phillipdavidstearns/7s7z1s2z/images/MountPi.jpg

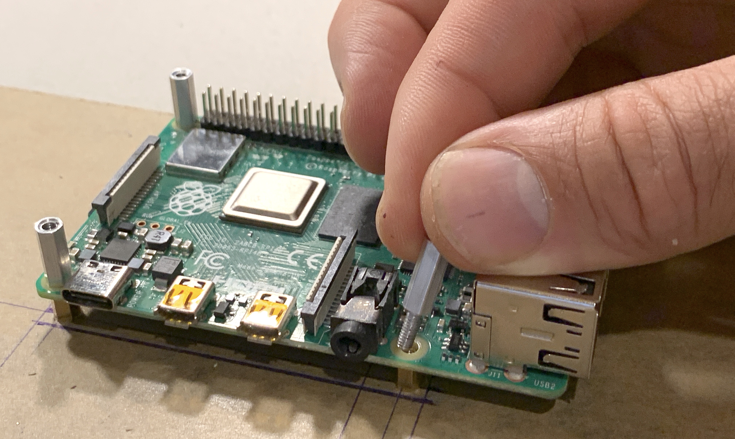
images/MountPi.jpg
