phillipdavidstearns/7s7z1s2z/PCB_rev_2/ferrite_encoder.jpg

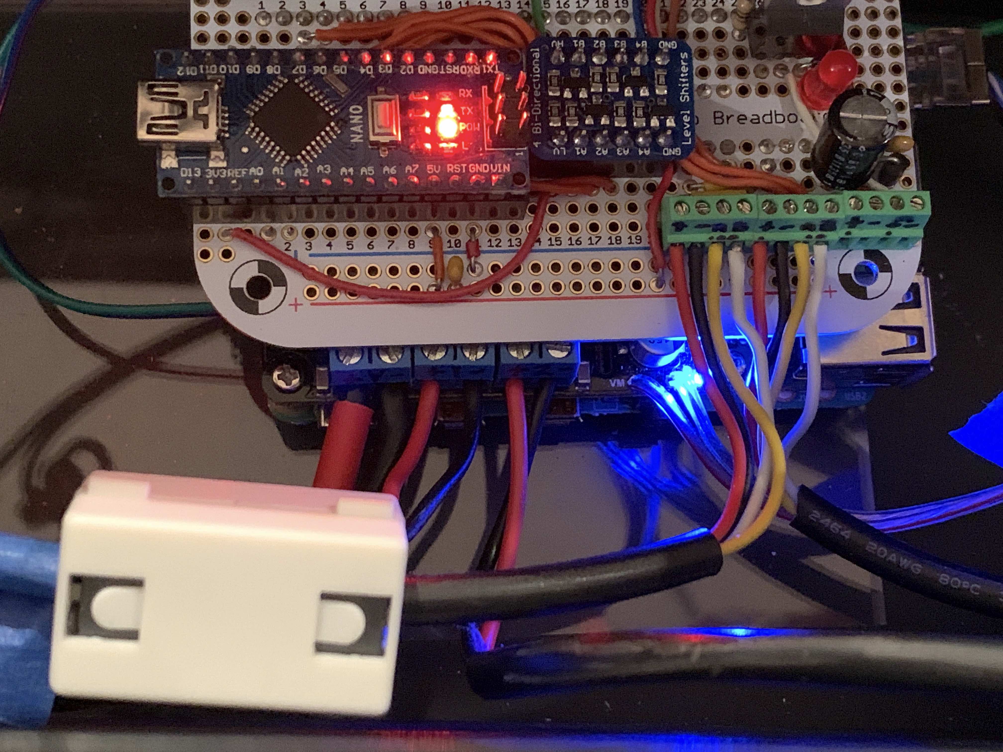
PCB_rev_2/ferrite_encoder.jpg
