phillipdavidstearns/7s7z1s2z/PCB_rev_2/PCB_new.jpg

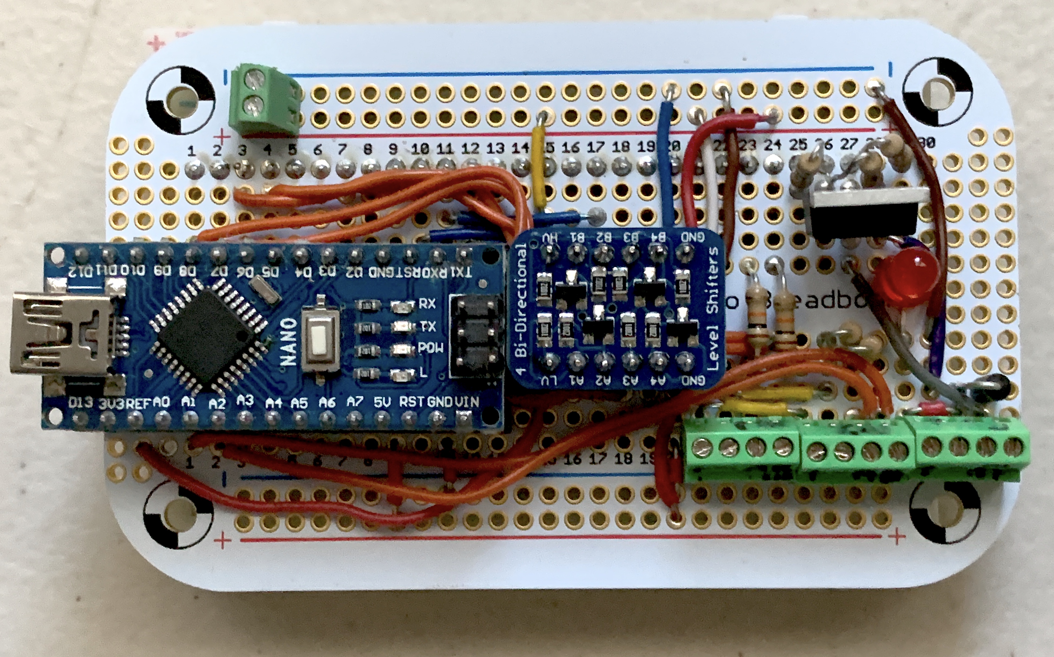
PCB_rev_2/PCB_new.jpg
