phillipdavidstearns/7s7z1s2z/(commit log)

2020-03-12 testing motors
2021-07-08 porting from arduino to python
2021-07-09 created MotorController class, integrated it insto the webApp
2021-07-10 smoothing out wrinkles in motor startup, shutdown. simplify encoder logic
2021-07-10 established functional link between the web app and MotorControl
2021-07-13 can toggle motor direction, save & load settings & defaults
2021-07-14 added pump controls to the web app
2021-07-15 websocket object now stored in MotorController, completed draft of documentation.
2021-07-20 changes to documentation: wire color codes
2021-07-21 changes to color code of wire
2021-07-21 instructions for conditioning wire
2021-08-09 websockets update, pump control update, pause/resume logic update
2021-08-10 changed constraints on position settings, added button for open and hold, removed power limit from changable settings
2021-08-13 attempting to resolve pump control issues. created local pigpio.pi object instance within MotorController class.
    [motor_controller.py]
2021-08-20 reworked progress logic to fix unexpected goto() behavior, added emergency stop, added separate offset set and apply buttons, prevent settings from being applied when sculpture is in motion.
    [motor_controller.py, server.py]
2021-10-15 work around for encoder
2021-10-20 encoder_serial.py implements pyserial-asyncio
2021-12-02 update to documentation. new PCB
